open-ephys/open-ephys-kicad-library/packages3d-source/CUI_UJ2-MBH-X-SMT.SLDASM

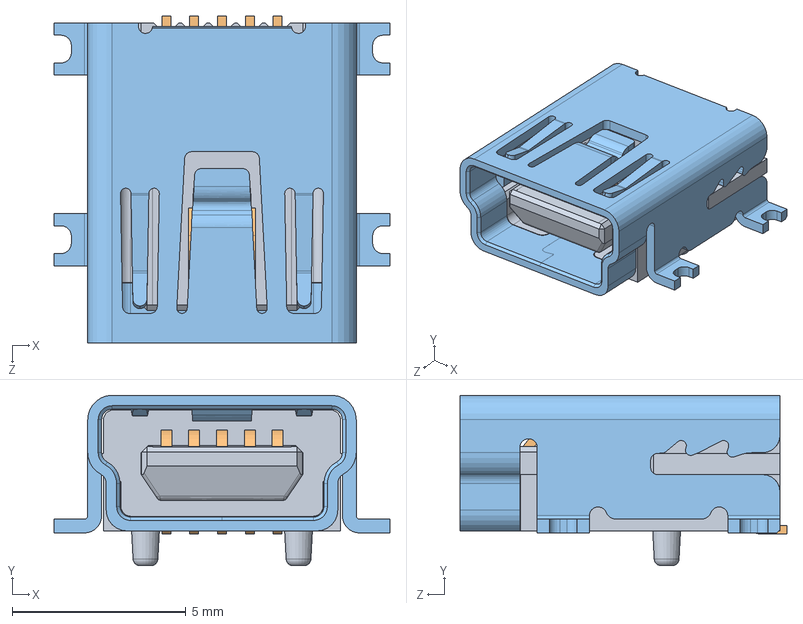
[picture p1: CAD file, 2024-04-23]
packages3d-source/CUI_UJ2-MBH-X-SMT.SLDASM
9.66 x 4.90 x 9.40 mm
internal housing
5_1_Pin x 5
housing
