open-ephys/open-ephys-kicad-library/packages3d-source/TI_YBH0004_DSBGA4-0.761x0.761x0.4mm.SLDPRT

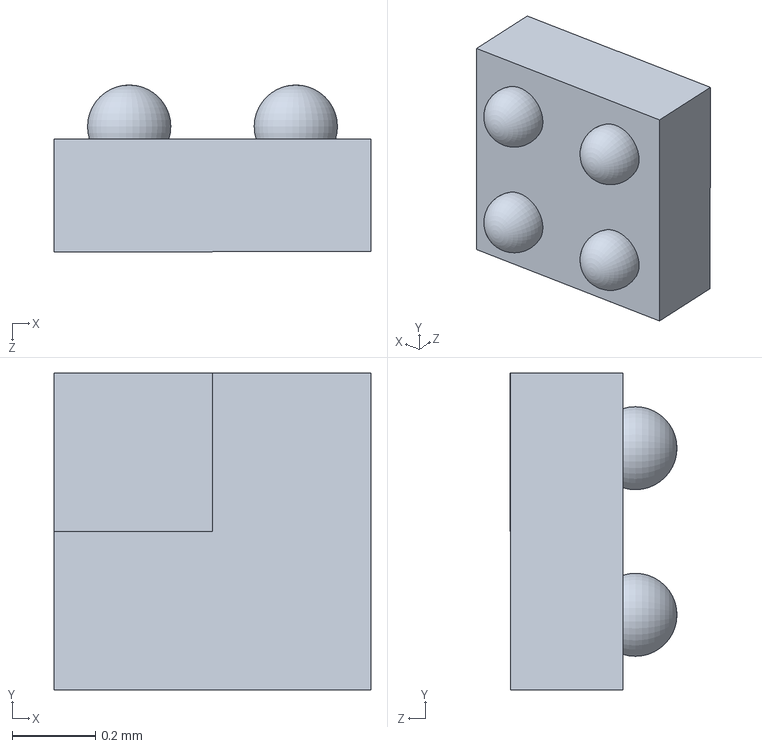
[picture p2: CAD file, 2026-07-14]
packages3d-source/TI_YBH0004_DSBGA4-0.761x0.761x0.4mm.SLDPRT
0.761 x 0.761 x 0.401 mm
