open-ephys/open-ephys-kicad-library/packages3d-source/LUMEX_SSF-LXH100GD-01.SLDPRT

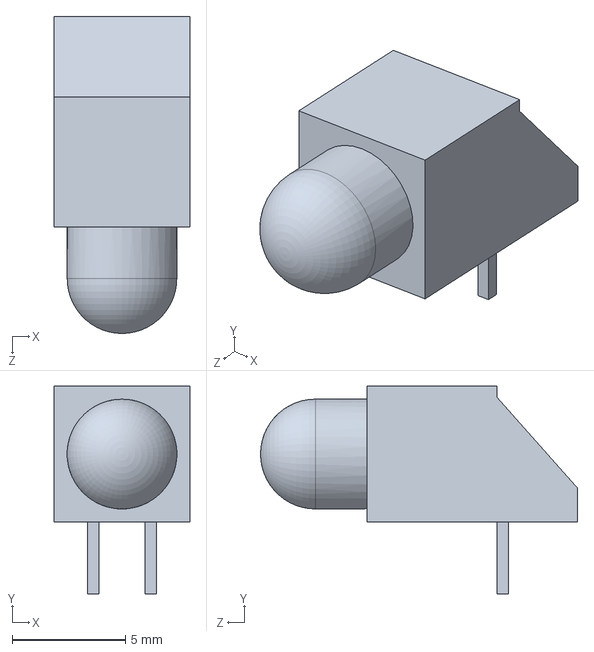
[picture p3: CAD file, 2026-04-23]
packages3d-source/LUMEX_SSF-LXH100GD-01.SLDPRT
6.00 x 9.18 x 14.0 mm
