open-ephys/open-ephys-kicad-library/packages3d-source/ONSEMI_567SV_WLCSP9-3x3-1.215x1.385x0.581mm-P0.4mm.SLDPRT

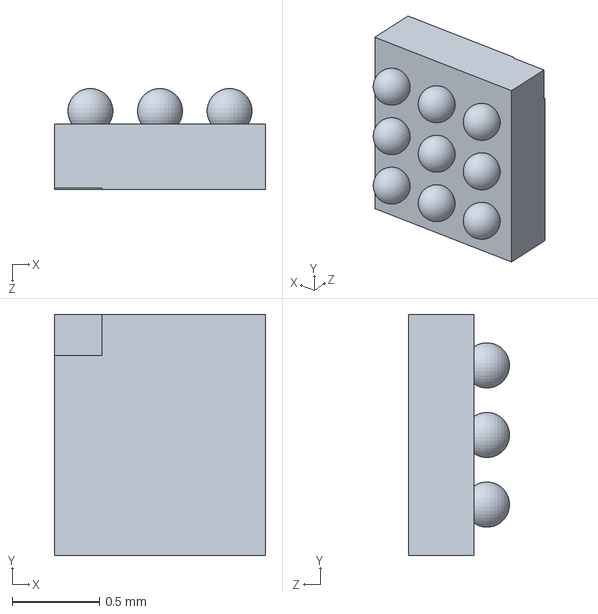
[picture p4: CAD file, 2026-01-16]
packages3d-source/ONSEMI_567SV_WLCSP9-3x3-1.215x1.385x0.581mm-P0.4mm.SLDPRT
1.22 x 1.38 x 0.581 mm
