open-ephys/open-ephys-kicad-library/packages3d-source/SCIENCE_CSBGA-728_26x28_4.0x4.0mm_NoCornerBumps.SLDPRT

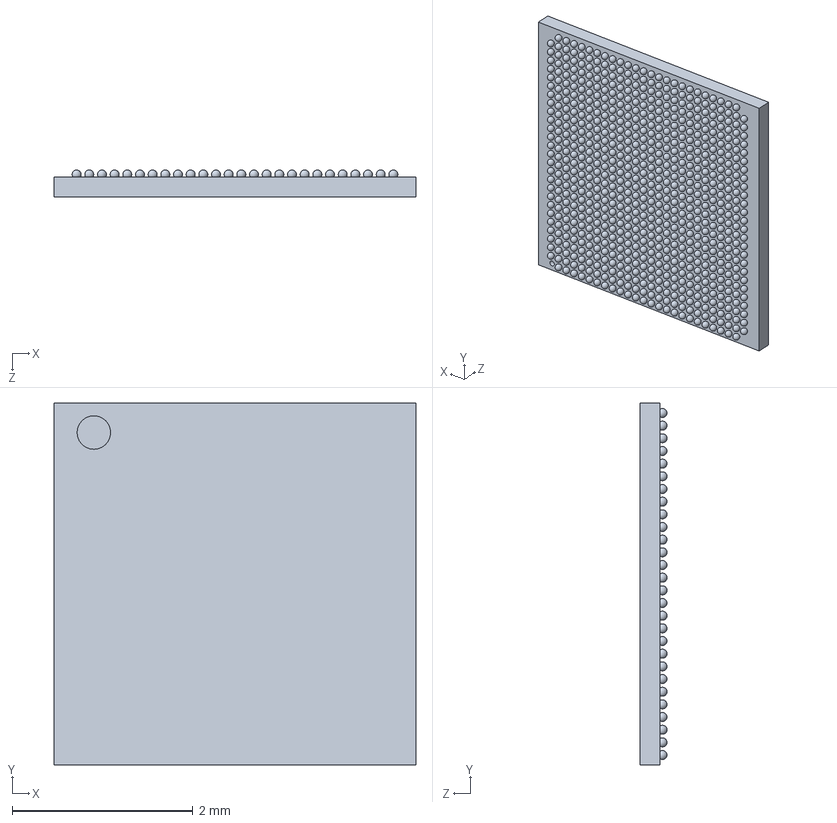
[picture p5: CAD file, 2025-06-20]
packages3d-source/SCIENCE_CSBGA-728_26x28_4.0x4.0mm_NoCornerBumps.SLDPRT
4.00 x 4.00 x 0.3 mm
