open-ephys/open-ephys-kicad-library/packages3d-source/RENESAS_WLCSP-8_1.6x1.35x0.25mm_P0.4mm_Ball0.21mm.SLDPRT

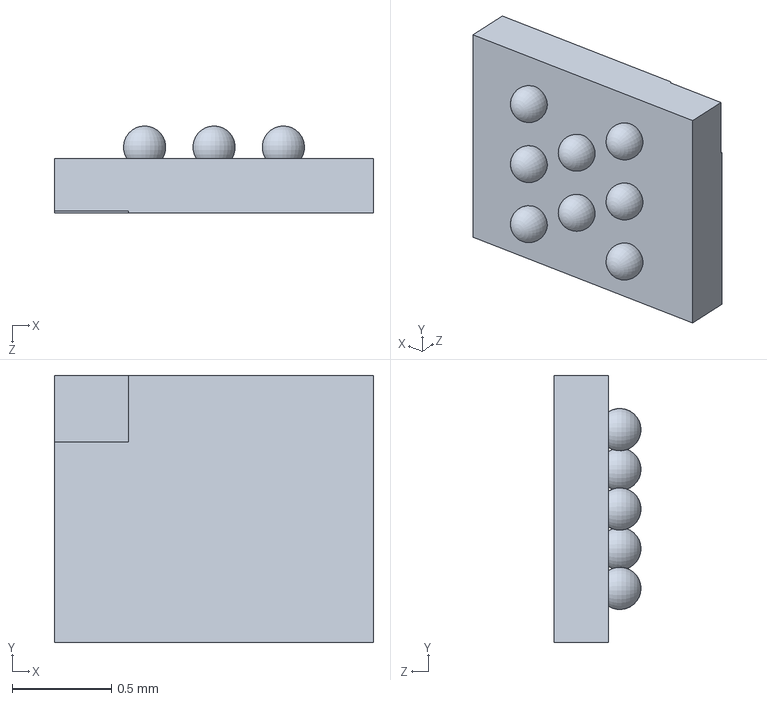
[picture p6: CAD file, 2025-06-20]
packages3d-source/RENESAS_WLCSP-8_1.6x1.35x0.25mm_P0.4mm_Ball0.21mm.SLDPRT
1.61 x 1.35 x 0.439 mm
