open-ephys/open-ephys-kicad-library/packages3d-source/ANALOG_CP-12-8_LFCSP-12-1EP_7x7mm_P1.7mm_EP2.8x2.8mm.SLDPRT

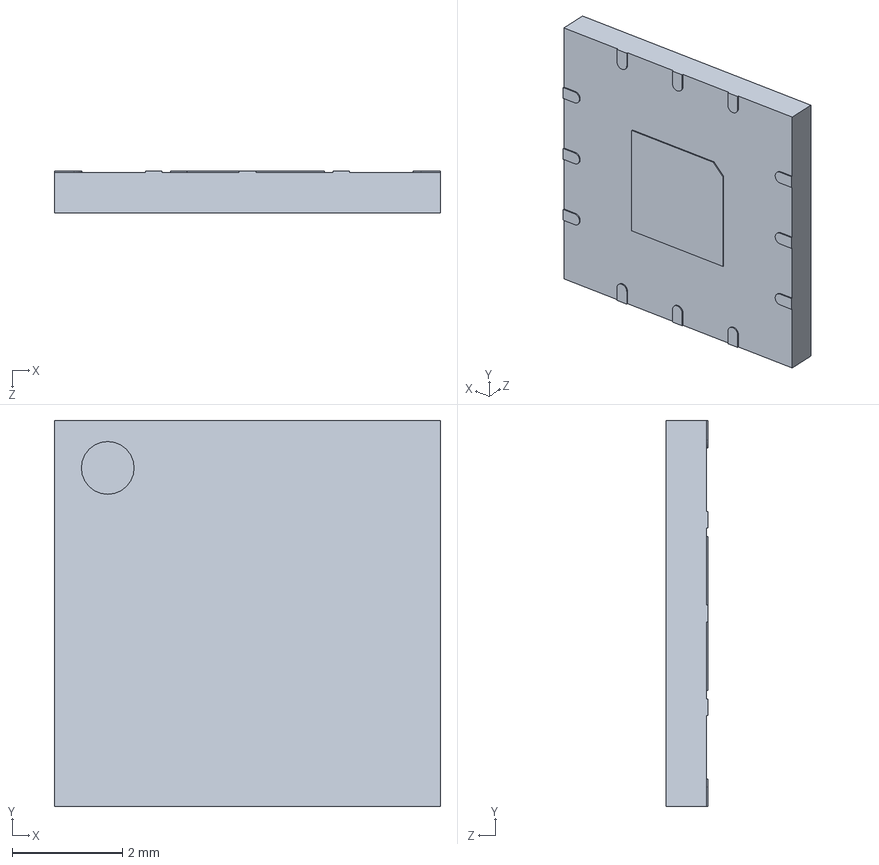
[picture p7: CAD file, 2024-05-22]
packages3d-source/ANALOG_CP-12-8_LFCSP-12-1EP_7x7mm_P1.7mm_EP2.8x2.8mm.SLDPRT
7.00 x 7.00 x 0.76 mm
