open-ephys/open-ephys-kicad-library/packages3d-source/WSON-8-1EP_6x5mm_P1.27mm_EP3.4x4.3mm.SLDPRT

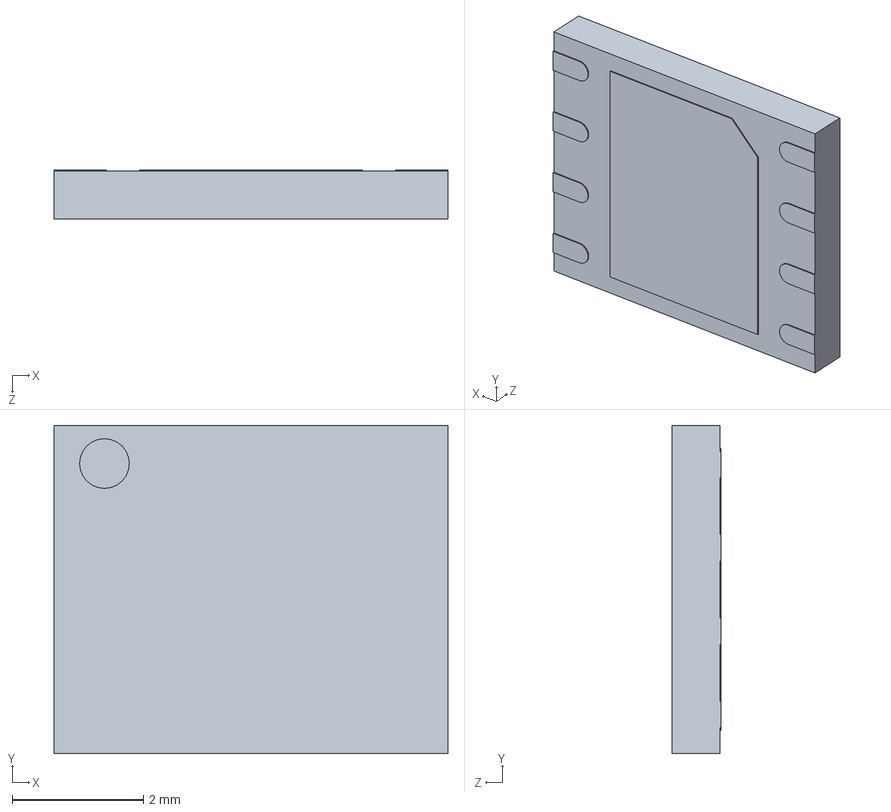
[picture p8: CAD file, 2024-02-15]
packages3d-source/WSON-8-1EP_6x5mm_P1.27mm_EP3.4x4.3mm.SLDPRT
6.00 x 5.00 x 0.75 mm
