open-ephys/open-ephys-kicad-library/packages3d-source/LED_SK6805_PLCC4_2.4x2.7mm_P1.3mm.SLDPRT

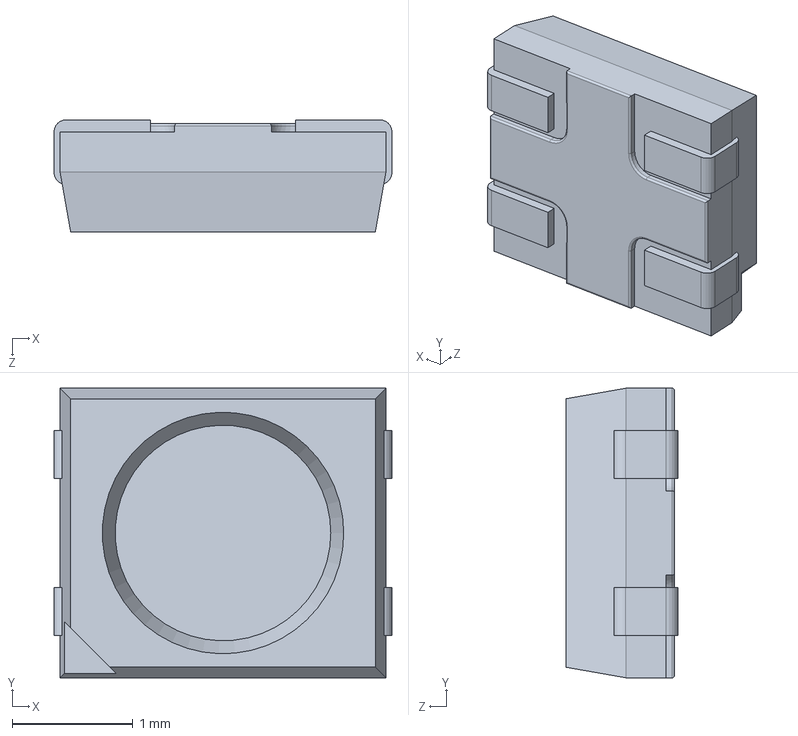
[picture p9: CAD file, 2024-02-15]
packages3d-source/LED_SK6805_PLCC4_2.4x2.7mm_P1.3mm.SLDPRT
2.80 x 2.40 x 0.93 mm
