open-ephys/open-ephys-kicad-library/packages3d-source/L_Sumida_0630CDMCD_7x6.6mm.SLDPRT

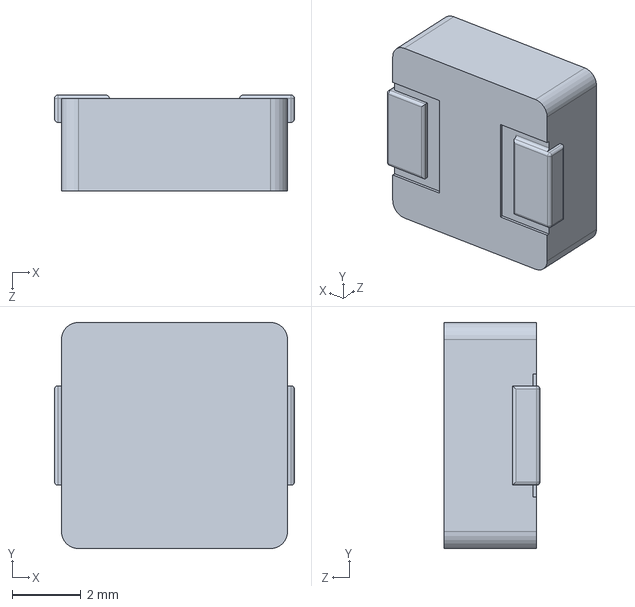
[picture p10: CAD file, 2024-02-15]
packages3d-source/L_Sumida_0630CDMCD_7x6.6mm.SLDPRT
7.00 x 6.60 x 2.80 mm
