open-ephys/open-ephys-kicad-library/packages3d-source/TI_RPG0014A_VQFN14-HR_3x2x1mm.SLDPRT

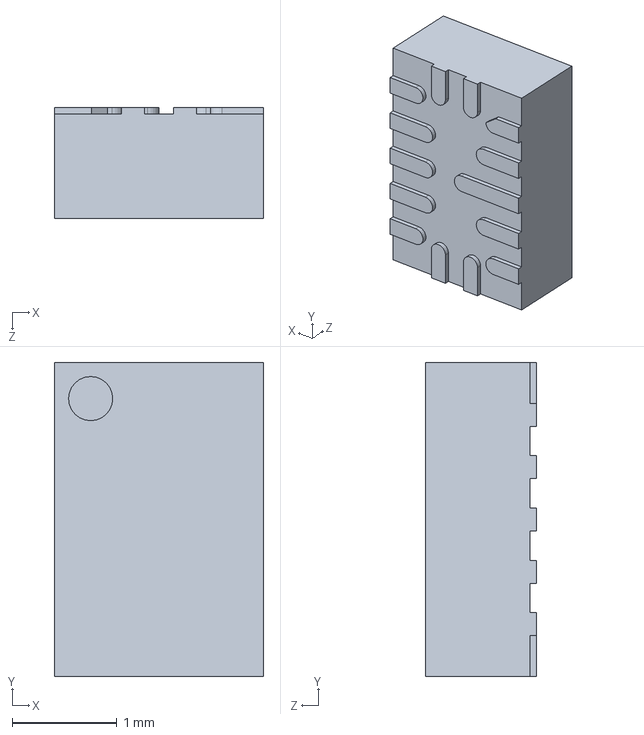
[picture p11: CAD file, 2024-01-18]
packages3d-source/TI_RPG0014A_VQFN14-HR_3x2x1mm.SLDPRT
2.00 x 3.00 x 1.06 mm
