open-ephys/open-ephys-kicad-library/packages3d-source/EATON_HV0820-2R7305-R_SMD.SLDPRT

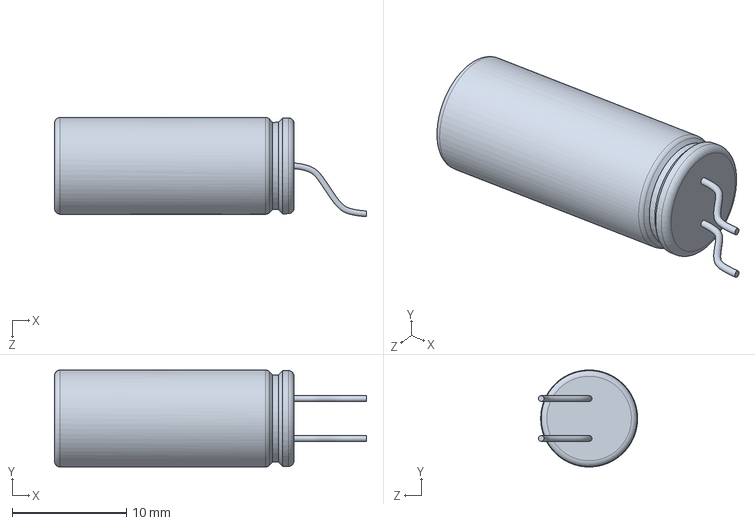
[picture p12: CAD file, 2023-11-22]
packages3d-source/EATON_HV0820-2R7305-R_SMD.SLDPRT
27.3 x 8.50 x 8.70 mm
