open-ephys/open-ephys-kicad-library/packages3d-source/TI_R-PDSS_B4_SMD.SLDPRT

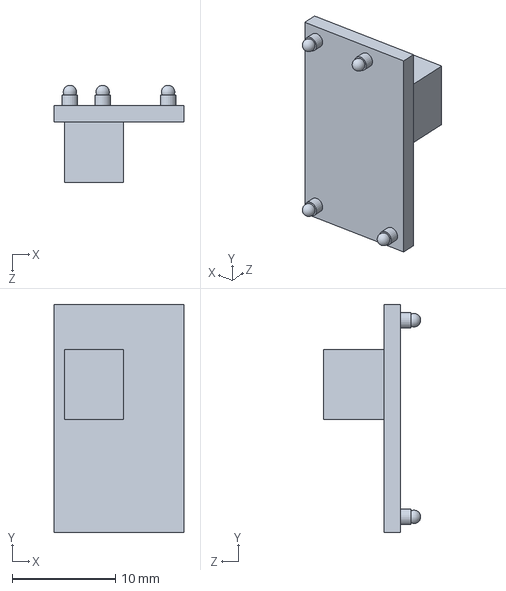
[picture p13: CAD file, 2023-11-21]
packages3d-source/TI_R-PDSS_B4_SMD.SLDPRT
12.6 x 22.1 x 9.45 mm
