open-ephys/open-ephys-kicad-library/packages3d-source/VQFN-20-1EP_3x3mm_P0.4mm_EP1.7x1.7mm.SLDPRT

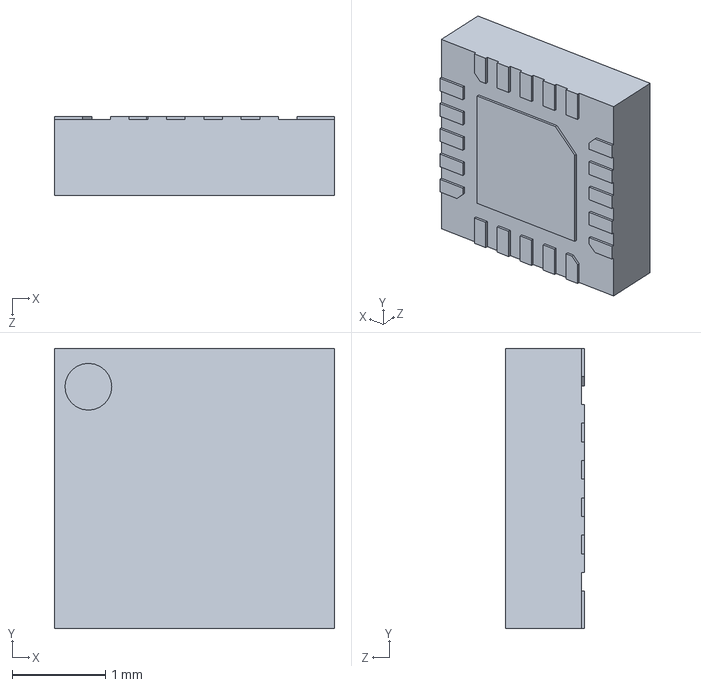
[picture p14: CAD file, 2023-10-11]
packages3d-source/VQFN-20-1EP_3x3mm_P0.4mm_EP1.7x1.7mm.SLDPRT
3.00 x 3.00 x 0.85 mm
