open-ephys/open-ephys-kicad-library/packages3d-source/IMEC_BGA-484_22x22_12.0x12.0x1.2mm.SLDPRT

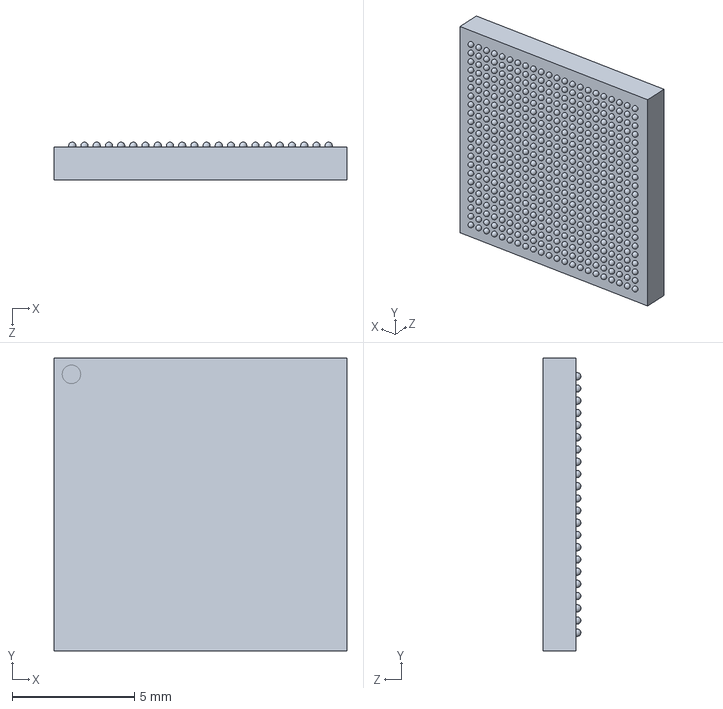
[picture p15: CAD file, 2023-08-04]
packages3d-source/IMEC_BGA-484_22x22_12.0x12.0x1.2mm.SLDPRT
12.0 x 12.0 x 1.55 mm
