open-ephys/open-ephys-kicad-library/packages3d-source/ECS_1612MV_4Pin_1.6x1.2mm.SLDPRT

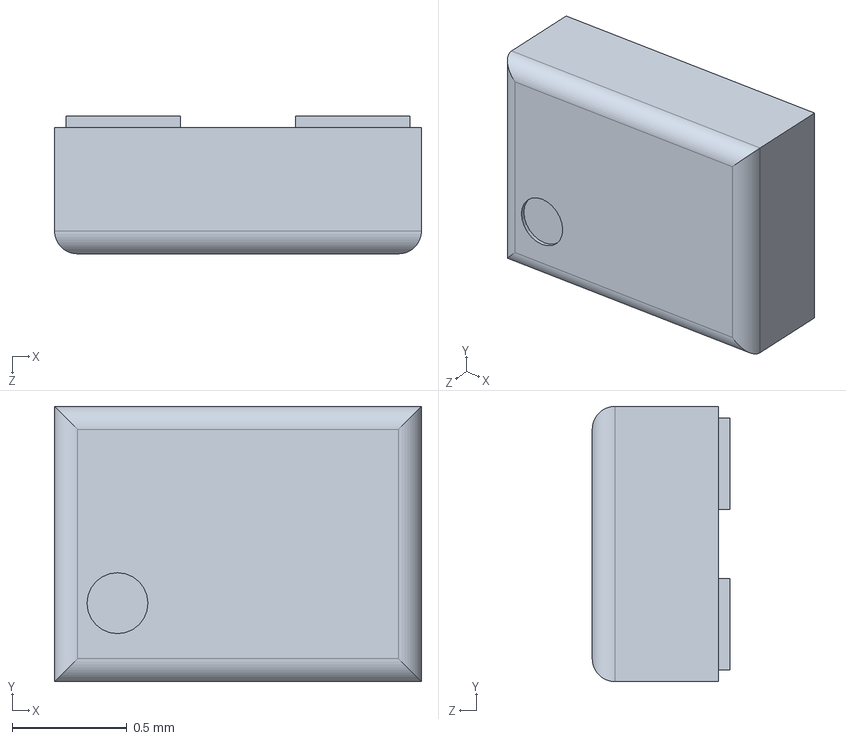
[picture p16: CAD file, 2023-08-02]
packages3d-source/ECS_1612MV_4Pin_1.6x1.2mm.SLDPRT
1.60 x 1.20 x 0.6 mm
