open-ephys/open-ephys-kicad-library/packages3d-source/ANALOG_CB-16-8_BGA-16_4x4_2.0x2.0mm.SLDPRT

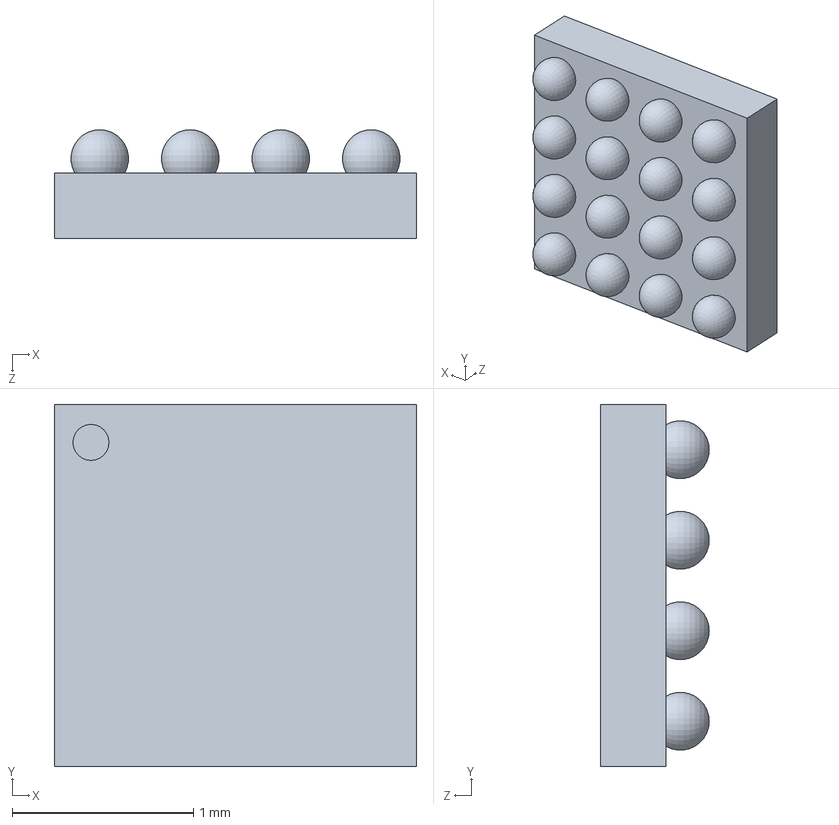
[picture p17: CAD file, 2023-07-26]
packages3d-source/ANALOG_CB-16-8_BGA-16_4x4_2.0x2.0mm.SLDPRT
2.00 x 2.00 x 0.6 mm
