open-ephys/open-ephys-kicad-library/packages3d-source/VISHAY_miniQFN-16L_2.6x1.8mm_P0.4mm.SLDPRT

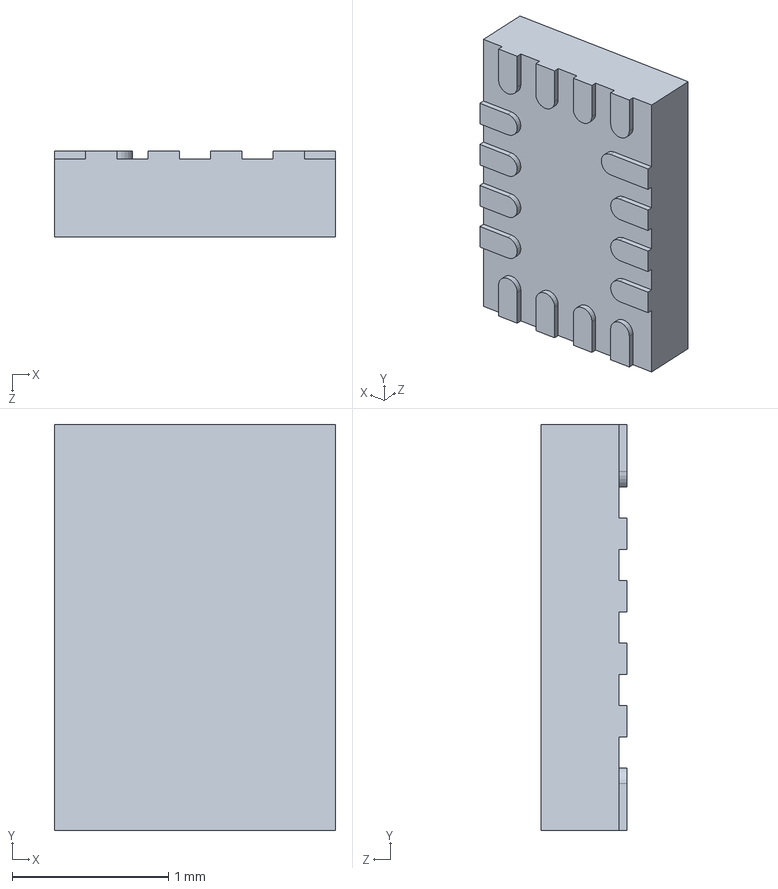
[picture p18: CAD file, 2023-07-26]
packages3d-source/VISHAY_miniQFN-16L_2.6x1.8mm_P0.4mm.SLDPRT
1.80 x 2.60 x 0.55 mm
