open-ephys/open-ephys-kicad-library/packages3d-source/ANALOG_CB-6-2_BGA-6_2x3_1.0x1.45mm.SLDPRT

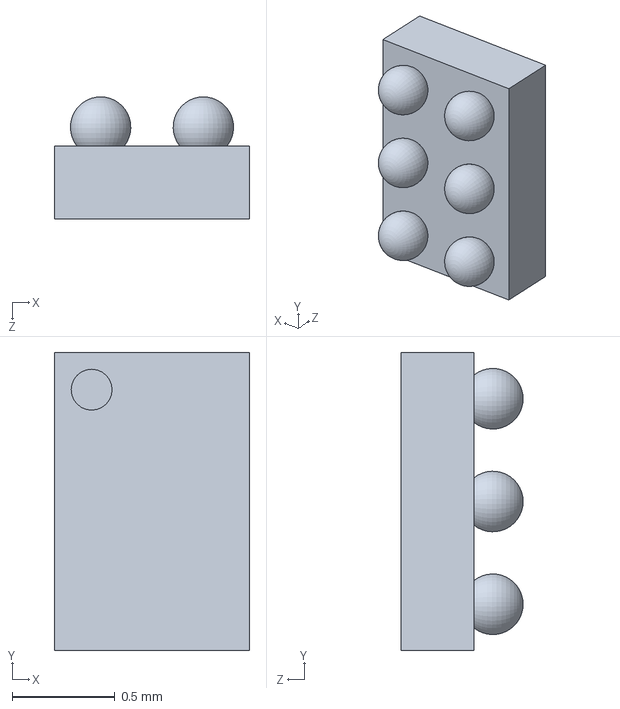
[picture p19: CAD file, 2023-07-20]
packages3d-source/ANALOG_CB-6-2_BGA-6_2x3_1.0x1.45mm.SLDPRT
0.95 x 1.45 x 0.595 mm
