open-ephys/open-ephys-kicad-library/packages3d-source/JST_SM08B-SURS-TF.SLDPRT

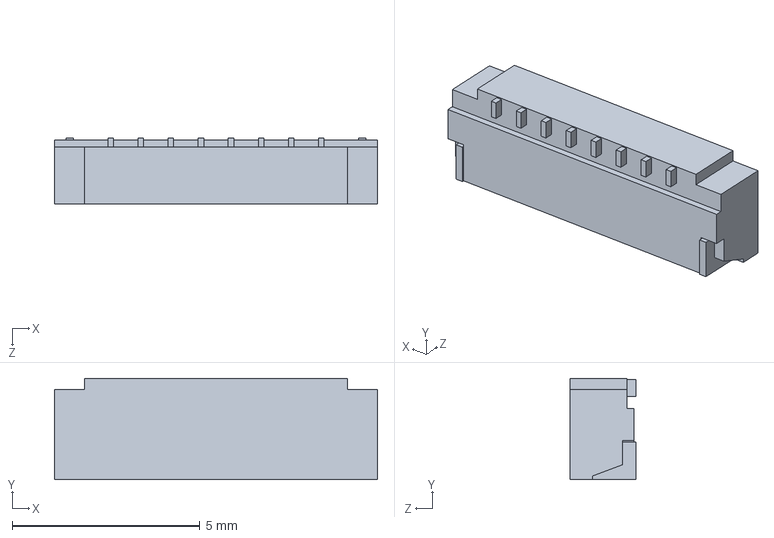
[picture p20: CAD file, 2023-05-05]
packages3d-source/JST_SM08B-SURS-TF.SLDPRT
8.60 x 2.70 x 1.75 mm
