open-ephys/open-ephys-kicad-library/packages3d-source/BIVAR_SLP3-150-100-R.sldprt

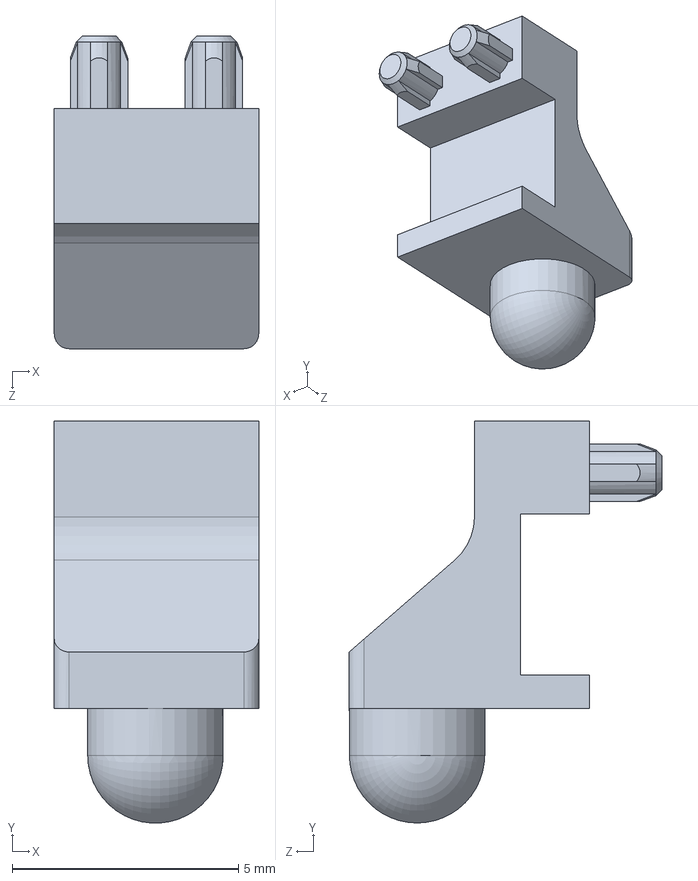
[picture p21: CAD file, 2023-05-05]
packages3d-source/BIVAR_SLP3-150-100-R.sldprt
4.52 x 8.89 x 6.91 mm
