open-ephys/open-ephys-kicad-library/packages3d-source/EAST1616RGBA8.SLDASM

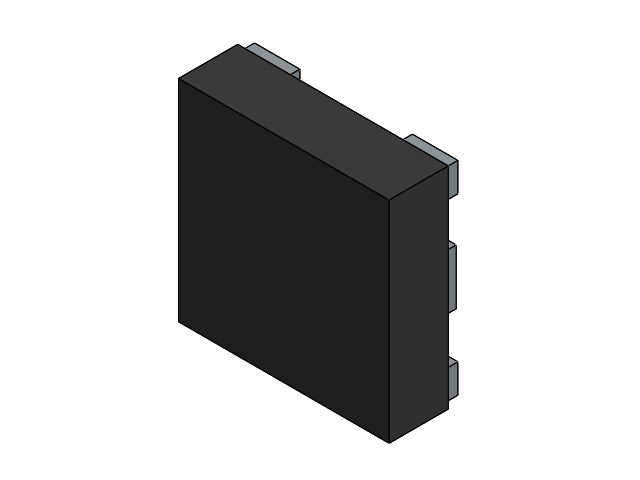
[picture p22: CAD file, 2023-05-05]
packages3d-source/EAST1616RGBA8.SLDASM
Body.stp
Pins.stp
