open-ephys/open-ephys-kicad-library/(list of files, cad)

Other CAD files:
packages3d-source/CUI_internal-housing.SLDPRT
packages3d-source/CUI_housing.SLDPRT
packages3d-source/CUI_5_1_Pin.SLDPRT
