open-ephys/open-ephys-kicad-library/(threads)

Thread 1 (2023-05-18):

Check the SODIMM-204 symbol versus JEDEC standard

jonnew, 2023-05-18:
I would like a different set of eyes on this symbol to make sure it matches the JEDEC 4.20.18 - 204-Pin DDR3 SDRAM Unbuffered SO-DIMM Design Specification, pg. 9.

https://github.com/open-ephys/open-ephys-kicad-library/blob/d3c637c917d6b90d7a55e052ff7f3a11bd596c9a/symbols/open-ephys.kicad_sym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

cjsha, 2023-05-22:
The symbol's pin mapping matches jedec's pin mapping. I don't think this matters, but (just in case) this is what I noted about naming convention:
- "_n" and "_c" are converted to "#"
- "_t" is omitted
- "S" is converted to "CS" for chip select pins
- Pins 83/107 are dual function or doubled labelled, which isn't indicated in the symbol

Closed 2023-05-22.

Thread 2 (2023-07-08):

Review NRIC1384 pinout

jonnew, 2023-07-08:
NRIC1384 is the BGA-packaged neuropixels 1.0 chip. It uses a 484 pin package. It needs a review to ensure pins are not misplaced. This is critical since this chip is so expensive.

cjsha, 2023-07-24:
I couldn't find the pinout.. Can you link it here?

jonnew, 2023-07-24:
I sent it your privately. Unfortunately, its not public in so far as I understand IMEC's sharing policy.

cjsha, 2023-07-25:
GNIO -> GND_IO (or GND_I0 if you don't make the next change): R20
I0 -> IO: H21, H22, R21
VBAISP_BG -> VBIASP_BG: U20
VDD2AV -> VDDA2V: D22, E20, M1, W19, W22, V20
Only the first edit will actually change the resulting nets. The second edit I think is better for clarity maybe. The rest are just so they match the datasheet but won't actually change nets or anything else as far as putting together the schematic/pcb in kicad. They are not necessary, but I took note of them anyway just in case

cjsha, 2023-07-27:
Can you close this issue when you commit the fixes?

jonnew, 2023-07-27:
Thanks for the reminder, fixed in 324cb38.

Closed 2023-07-27.

Thread 4 (2024-03-20):

Make Serial Number sticker footprints

jonnew, 2024-03-20:
When possible, its best to leave an available footprint of 5x5 or 8x20 mm on the PCBs for the labels that contain the serial number.
Maybe it makes sense to create a SN_STICKER or similar component in the KiCAD library for these 2 sizes.

jonnew, 2024-10-31:
Fixed by d2d6fcd

Closed 2024-10-31.

Thread 5 (2024-06-16):

Edit README.md So That Library Nicknames Are Consistent to Facilitate Copying-and-Pasting

cjsha, 2024-06-16:
This issue is attempting to facilitate copying-and-pasting of motifs from one schematic to another schematic (in particular, schematics that were made by different users).

For instance:
When symbols are placed on a schematic and assigned a footprint, the footprint is assigned with the following notation: `<footprint-library-nickname>:<footprint-name>`. Therefore, symbols that are copied from a document made by a user and pasted into a document made by another user generates DRC complaints ("The current configuration does not include the library `open-ephys") if those users set different nicknames for the Open Ephys libraries in the Library Manager.  This creates an annoyance for users copying-and-pasting circuit motifs from documents that were created in an environment where the Open Ephys KiCad libraries have different nicknames.

@cjsha uses the nickname `oe`. @jonnew uses the nickname `open-ephys`. Let's settle on one and make it an "official" KiCad library nickname for developers of Open Ephys hardware by putting it in the README.md.
