open-ephys/open-ephys-kicad-library/(commit log)

2023-05-05 part files for LED PCB
    - not perfectly compliant with klc.kicad.org i.e. the jst connector
    and smd led might need to have a different names that are more
    general, but it's pretty close
    - this organization of directories reflects that of kicad's repos on
    gitlab.com/kikcad/libraries
    - all footprints in one .pretty folder for now until folder gets full like 200+
    footprints
    - no symbol for now. they are modified kicad symbols. still need
    [BIVAR_SLP3-150-100-R.sldprt, EAST1616RGBA8.SLDASM, JST_SM08B-SURS-TF.SLDPRT]
2023-05-17 Added RA SODIMM-204 symbol, footprint, and 3d model
    - Footprint is from JEDEC standard
    - 3D model is TE part
    - Symbol is from JEDEC standard with MPx added to fit RA parts
2023-05-31 Added components for input power protection
    - Low on NFETs
    - LTC4365 OV/UV/Reverse current protection
    - Minor changes to SODIMM-204 to better reflect JEDEC naming convensions
2023-06-23 Devices for headstage-neuropix1e and SPI RHD headstage
2023-06-23 Add Omnetics A79626 12-pin footprint
2023-06-29 Added parts for RHD2164 SPI Headstage
2023-07-20 Added 3D models for two parts
    - ANALOG_CB-6-2_BGA-6_2x3_1.0x1.45mm
    - IMEC_BGA-484_22x22_12.0x12.0x1.2mm
    [ANALOG_CB-6-2_BGA-6_2x3_1.0x1.45mm.SLDPRT, IMEC_BGA-484_22x22_12.0x12.0x1.2mm.SLDPRT]
2023-07-26 Parts for headstage-neuropix1bga
    - Also added some missing 3D models
    [ANALOG_CB-16-8_BGA-16_4x4_2.0x2.0mm.SLDPRT, VISHAY_miniQFN-16L_2.6x1.8mm_P0.4mm.SLDPRT]
2023-08-02 Added ECS 1.6x1.2mm oscillator
    - And other updates for headstage-neuropix1bga
    [ECS_1612MV_4Pin_1.6x1.2mm.SLDPRT]
2023-08-02 Fixed .gitignore to permit footprints subdirectories
    - And added missing footprints
2023-08-04 Fix IMEC_BGA-484_22x22_12.0x12.0x1.2mm 3D model thickness
    [IMEC_BGA-484_22x22_12.0x12.0x1.2mm.SLDPRT]
2023-08-22 Fix molex 203390-0323 footprint
    - And added dedicated symbol that maps topologically to its quad row
    layout
2023-09-08 Fix IMEC-BGA-484 3D model
    - Add Hirose FH35 NP2.0 connector
    - Other small things
2023-09-13 Added ST_QFN12L_2.2x1.4x0.55mm_P0.4mm footprint
    - Also corrected courtyard on HIROSE_FH35C-17S-0.3SHW(99)
2023-10-05 symbols and footprints for kiloscope pcb
    - MAX20019 (dual output switching regulator)
    - MIC2293 (laser diode driver)
    - PMXultra-tiny FET
2023-10-11 Added ONSEMI 711BH fet package
    - 0.62x0.42mm power FET
2023-10-11 Added VQFN-20-1EP_3x3mm_P0.4mm_EP1.7x1.7mm 3d model
    [VQFN-20-1EP_3x3mm_P0.4mm_EP1.7x1.7mm.SLDPRT]
2023-11-17 Add LTC4425
    - Supercap charger
    - Uses generic footprint
2023-11-18 Add Teensy LC
    - SMD footprint
    - Symbol exposes all outer connectors
2023-11-21 Add parts for commutator control board
    [TI_R-PDSS_B4_SMD.SLDPRT]
2023-11-22 More parts for commutator controller rev. C
    - Supercap 3D models
    - PCB touch sensor seed footprint
    [EATON_HV0820-2R7305-R_SMD.SLDPRT]
2023-12-05 Added I-Pass connectors
    - These are complex part aggregates (frame and actual connector) that
    need to be used together. They need physical verification before we
    are sure they are correct
2023-12-14 Add symbols for ephys-test-board
2024-01-18 Added parts for ONIX PCIe Host
    - Sumida 0630CDMCD
    - MOLEX 87832-1420
    - TI TPS51200DRC
    - TI TPS53318/9
    - TI TPS54J061
    [TI_RPG0014A_VQFN14-HR_3x2x1mm.SLDPRT]
2024-02-05 Add SAMTEC_ERM8_30 connector for pcie-modules
    - Different 3D model options because it comes in different
    stack height options
2024-02-08 Added ECS 3.2x2.5x1.2mm 4-pin oscillator package
2024-02-10 Added Lumex quad vertical light pipe model and footprint
2024-02-13 Add CTS 1200TA switch footprint and model
2024-02-14 Added littefuse 1812 PTC fuse footprint
    - Needs 3D model
2024-02-15 Add 3D modles for parts on pcie-host
    - Most of these footprints are copied out of the standard kicad
    libraries but they lacked 3D models
    [LED_SK6805_PLCC4_2.4x2.7mm_P1.3mm.SLDPRT, L_Sumida_0630CDMCD_7x6.6mm.SLDPRT, WSON-8-1EP_6x5mm_P1.27mm_EP3.4x4.3mm.SLDPRT]
2024-02-23 Fix BNO055 symbol
    - The offical KiCAD version has major errors (namely pin 15 and 16 are
    treated as GNDIO IO when they should be DNC)
2024-04-15 Add parts for onix-hostmod-crosslink-nx-tester
    - Schematic symbols for:
    - LIFCL-40-9BG400C (Lattice Crosslink FPGA)
    - PCB foorprints for:
    - LIFCL-40-9BG400C (Lattice Crosslink FPGA)
    - SAMTEC ERF8-030-XX.X-DV-K-TR (60 pin module connector)
2024-04-15 IPASS connector modifications
2024-04-23 Add library parts onix-hostmod-crosslink-nx-tester
    Added symbol for:
    - LIFCL-17-CSFBGA121
    Added footprints for:
    - CUI barrel connector
    - USB ESD IC
    [CUI_5_1_Pin.SLDPRT, CUI_UJ2-MBH-X-SMT.SLDASM, CUI_housing.SLDPRT, CUI_internal-housing.SLDPRT]
2024-04-23 Footprints for ONIX acqusition board
    - Eswitch push button improvements
    - Keystone 1045 test point
    - OEPS SN sticker part
    - M1.8 mounting hole
2024-04-24 Modify parts for onix-hostmod-crosslink-nx-tester
    - LIFCL-17 fpga has a footprint
    - LIFCL fpga footprints contain 3d bodies
    - single digit pin numbers changed from 0x -> x in SAMTEC ERF8 connector
2024-05-02 Library Update - onix-hostmod-crosslink-nx-tester
    - Added footprint for IDC header
    - Added footprint for 256 BGA FPGA
    - Added symbols for miscellaneous parts
2024-05-22 Add symbols, footprint, and model for ADHV4702-1
    - High-voltage opamp
    [ANALOG_CP-12-8_LFCSP-12-1EP_7x7mm_P1.7mm_EP2.8x2.8mm.SLDPRT]
2024-09-26 Add symbols for commutator pcb rev d
    - CAP1296
2024-11-11 Parts for ephys-test-board rev. A
2024-11-13 Parts for ephys test board
2024-11-19 Add samesky 6mm tactile SMD buton
2024-11-19 Add solder pasteless footprint for supercap
    - This supercap HV0820-2R7305-R on the commutator controller
2024-11-23 Add REF35xxx and LT675xD
    - Precision reference and high-voltage difference amplifier
2024-11-26 Add symbols for stimjim-hv
    - 13324-T196 transformer
    - ADS8681RUM ADC
    - AP7375-xxxx-13 LDO
    - LT8304 high voltage converter
2024-12-11 Parts for stimjim-hv
    - ADS9120 2.5MHz, 16-bit ADC
    - Silvertel AD7200 isolated DC/DC boost module
2024-12-16 Add TE 5227161-6 BNC connector
2025-01-21 Fix Same Sky TS04-66 tactile switch footprint
    - Add 3D model for 5.5mm actuator height variant
2025-02-06 Add footprints for ephys test board and module
    - Eswitch mini rocker
    - Thorlabs can packaged laser diode sockets
2025-02-07 Modify BNC_MOLEX_073100010.kicad_mod
    - Move PCB edge mark from fab to drawing layer on
    BNC_MOLEX_073100010.kicad_mod
2025-02-10 Updates while making commutator controller rev g
    - Add 5x5 OEPS QR code sticker footprint
    - Improve fab layers on several parts with better reference designator
    font sizes and more information
2025-02-11 Add 3D model to USB-C footprint
    - USB4110-GF-A
2025-03-30 Updates for Nixel-512 project
    - Nixel 512 CSBGA and interface components
    - Custom, low profile 01005 capacitor footprint
    - Move barcode drawing on OEPS sticker part to drawings layer instead of
    fab
    - Add wide sheet for long project names
2025-05-16 Fix GND pin direction on crosslink NX symbol
2025-06-20 Parts for headstage-nixel512
    - Land patterns and 3D models
    [RENESAS_WLCSP-8_1.6x1.35x0.25mm_P0.4mm_Ball0.21mm.SLDPRT, SCIENCE_CSBGA-728_26x28_4.0x4.0mm_NoCornerBumps.SLDPRT]
2025-07-10 Parts for nixel512 flex connector
2025-07-15 Add 64 pin quad row connector
    - Other fixes and 3D model additions
2025-11-12 Add MAX41400 symbol and footprint
    - Also some custom power symbols
2025-12-05 Add a 5x5 sticker footprint without courtyard
    - This way it can go "on top" of ICs on a design without DRC errors
2025-12-10 Corrected version of GCT USB4105 connector
    - The version in the KiCAD library does not properly
    indicate PCB edge
2025-12-24 Add LT1223 current feedback amplifier
    - 100MHz Current Feedback Amplifier
2026-01-13 Various components from laptop
    - Added FSA533 depletion mode analog switch
    - Added TLV9061SxDBV low cost, precision opamp
    - Other random updates too footprints that I forgot to commit
2026-01-16 Add Molex 5040703991 FPC mate
    - Also, add several missing 3D models
    [ONSEMI_567SV_WLCSP9-3x3-1.215x1.385x0.581mm-P0.4mm.SLDPRT]
2026-01-21 Added a lower spec version of the MOLEX_5040703991_FPC-mate
    - The original version requies 0.05mm traces and therefore is expensive
2026-02-03 Fixed TPS768xxQD symbol
    - Hidden pin was marked as Power Input instead of passive
2026-04-09 Add stimjim LED footprint & 3D model
    [LUMEX_SSF-LXH100GD-01.SLDPRT]
2026-04-09 add symbol for screw
2026-04-10 Add mounting holes for stimjim panels
2026-04-22 add LT1995CMS#PBF symbol + kicad 10 update
2026-04-29 Mark VCC and GND on FSA* analog switches as Power Input
    - They were previously inputs and this actually caused a real hardware
    error.
2026-05-31 Add ROHM BD70522GUL micro DC/DC converter
    - Tiny footprint and overall area
    - Pin-programmable output voltage
    - Updata 01005 capacitor 3D model
2026-07-13 Updates for ONIX SPI dongle
    - Move fab layers on 5x5mm on-IC OEPS sticker
    to user layers so they dont interfere with
    real fab information
    - Add TLV841MxxP and TLV841SxxD voltage
    supervisors
2026-07-14 Add 3D model for TI_YBH0004_WLCSP4-0.761x0.761x0.4mm
    - Also improve user comments on OEPS_SN-STICKER-5x5mm_OnTopOfIC to make
    them less invasive
2026-08-20 Add parts for OMNETICS_A79623-001 to HMDI-D adapter board
2026-09-30 Add ADS1x13 and X2QFN-10 footprint
